AhmadChowdhury/Calculator/(list of files, drawings)

Other design files:
ADDERSUBRACTOR2.pdsprj
ADDERSubtractorForPCB.pdsprj
DividerPCB.pdsprj
DividerShorted.pdsprj
MultiplierForPCB.pdsprj
MultiplierModified.pdsprj
